NotQuiteApex/JukeBox/README.md

# JukeBox!

An affordable, adorable, powerful hotkey device to run macros, play funny sounds, mute your microphone, change paint brush settings, or manage items in OBS! It can even have RGB or show PC stats!

(TODO: image here)

# Disclaimer
While this project is public, it is not ready for any sort of prime time.

# Docs and Assets
If you are the proud owner of a new JukeBox, or are building your own, take a look at the [getting started doc](docs/getting-started.md).

Sadly, not every program is compatible with these additional function keys, and some do not allow the use of these keys. There is a running list [here](docs/program-compatibility.md) of what programs do and do not work with the keys provided by JukeBox.

# Nightly builds
Each component of the project is built as it is updated. You can grab the latest version of each below. Nightly links provided by [nightly.link](https://nightly.link/).

| [Software, Windows (N/A)](https://nightly.link/FriendTeamInc/JukeBox/workflows/build-software.yaml/main/jb-software-windows.zip) | [Software, Linux](https://nightly.link/FriendTeamInc/JukeBox/workflows/build-software.yaml/main/jb-software-linux.zip) | [Firmware](https://nightly.link/FriendTeamInc/JukeBox/workflows/build-firmware.yaml/main/jb-firmware.zip) | [Hardware, Case](https://nightly.link/FriendTeamInc/JukeBox/workflows/build-hardware-case.yaml/main/jb-hardware-case.zip) | [Hardware, PCB](https://nightly.link/FriendTeamInc/JukeBox/workflows/build-hardware-pcb.yaml/main/jb-hardware-pcb.zip) |
| - | - | - | - | - |

# License
Copyright (c) 2020-2025 Logan "NotQuiteApex" Hickok-Dickson

All programming files, found in [`firmware/`](firmware/), [`software/`](software/), and [`hardware-case/`](hardware-case), are licensed under the [MIT license](https://mit-license.org/). All CAD files, found in [`hardware-pcb/`](hardware-pcb/), unless otherwise provided by an external source such as footprints or 3D models, are licesned under the [CC BY-NC-SA license](https://creativecommons.org/licenses/by-nc-sa/4.0/). Both licenses can be found with the given links or as files in the root of this repostiory.

If you would like to sell a variation of the board designed by you, reach out and an alternative license can be discussed and granted.
