NotQuiteApex/JukeBox/hardware-case/README.md

# JukeBox Case
Made with OpenSCAD 2024 (nightly), protects everything inside the JukeBox.
