NotQuiteApex/JukeBox/hardware-pcb/footprints/WS2812-2020.STEP

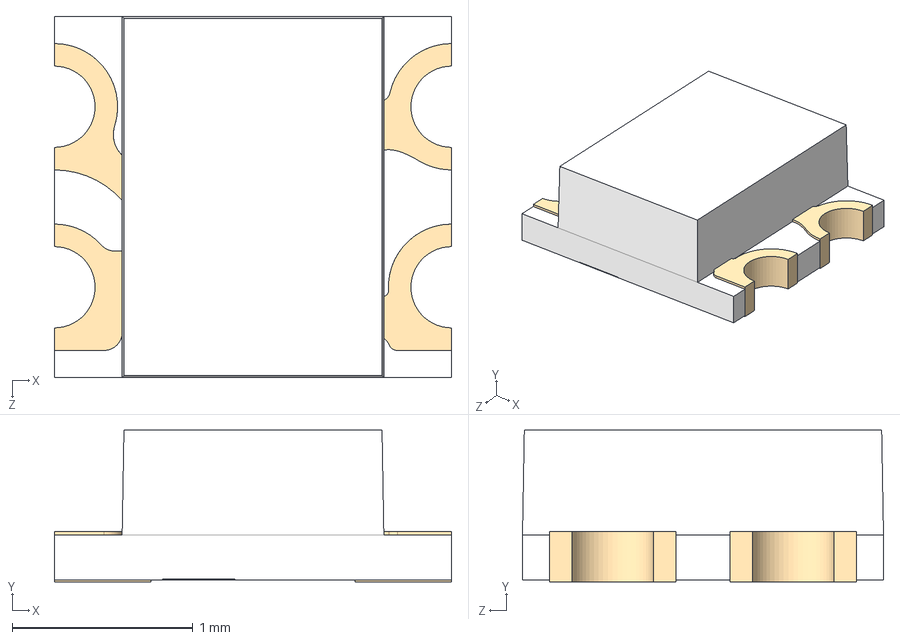
[picture p1: CAD file, 2024-10-28]
hardware-pcb/footprints/WS2812-2020.STEP
2.20 x 0.84 x 2.00 mm
