NotQuiteApex/JukeBox/hardware-pcb/footprints/SM04B-SRSS-TB(LF)(SN).STEP

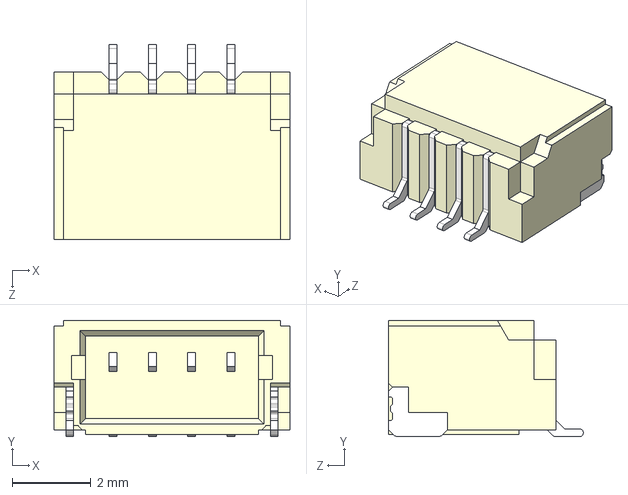
[picture p2: CAD file, 2024-10-28]
hardware-pcb/footprints/SM04B-SRSS-TB(LF)(SN).STEP
6.00 x 2.96 x 4.95 mm
