NotQuiteApex/JukeBox/hardware-pcb/JukeBox.kicad_pcb

## KiCad design hardware-pcb/JukeBox.kicad_pcb (2024-12-14)

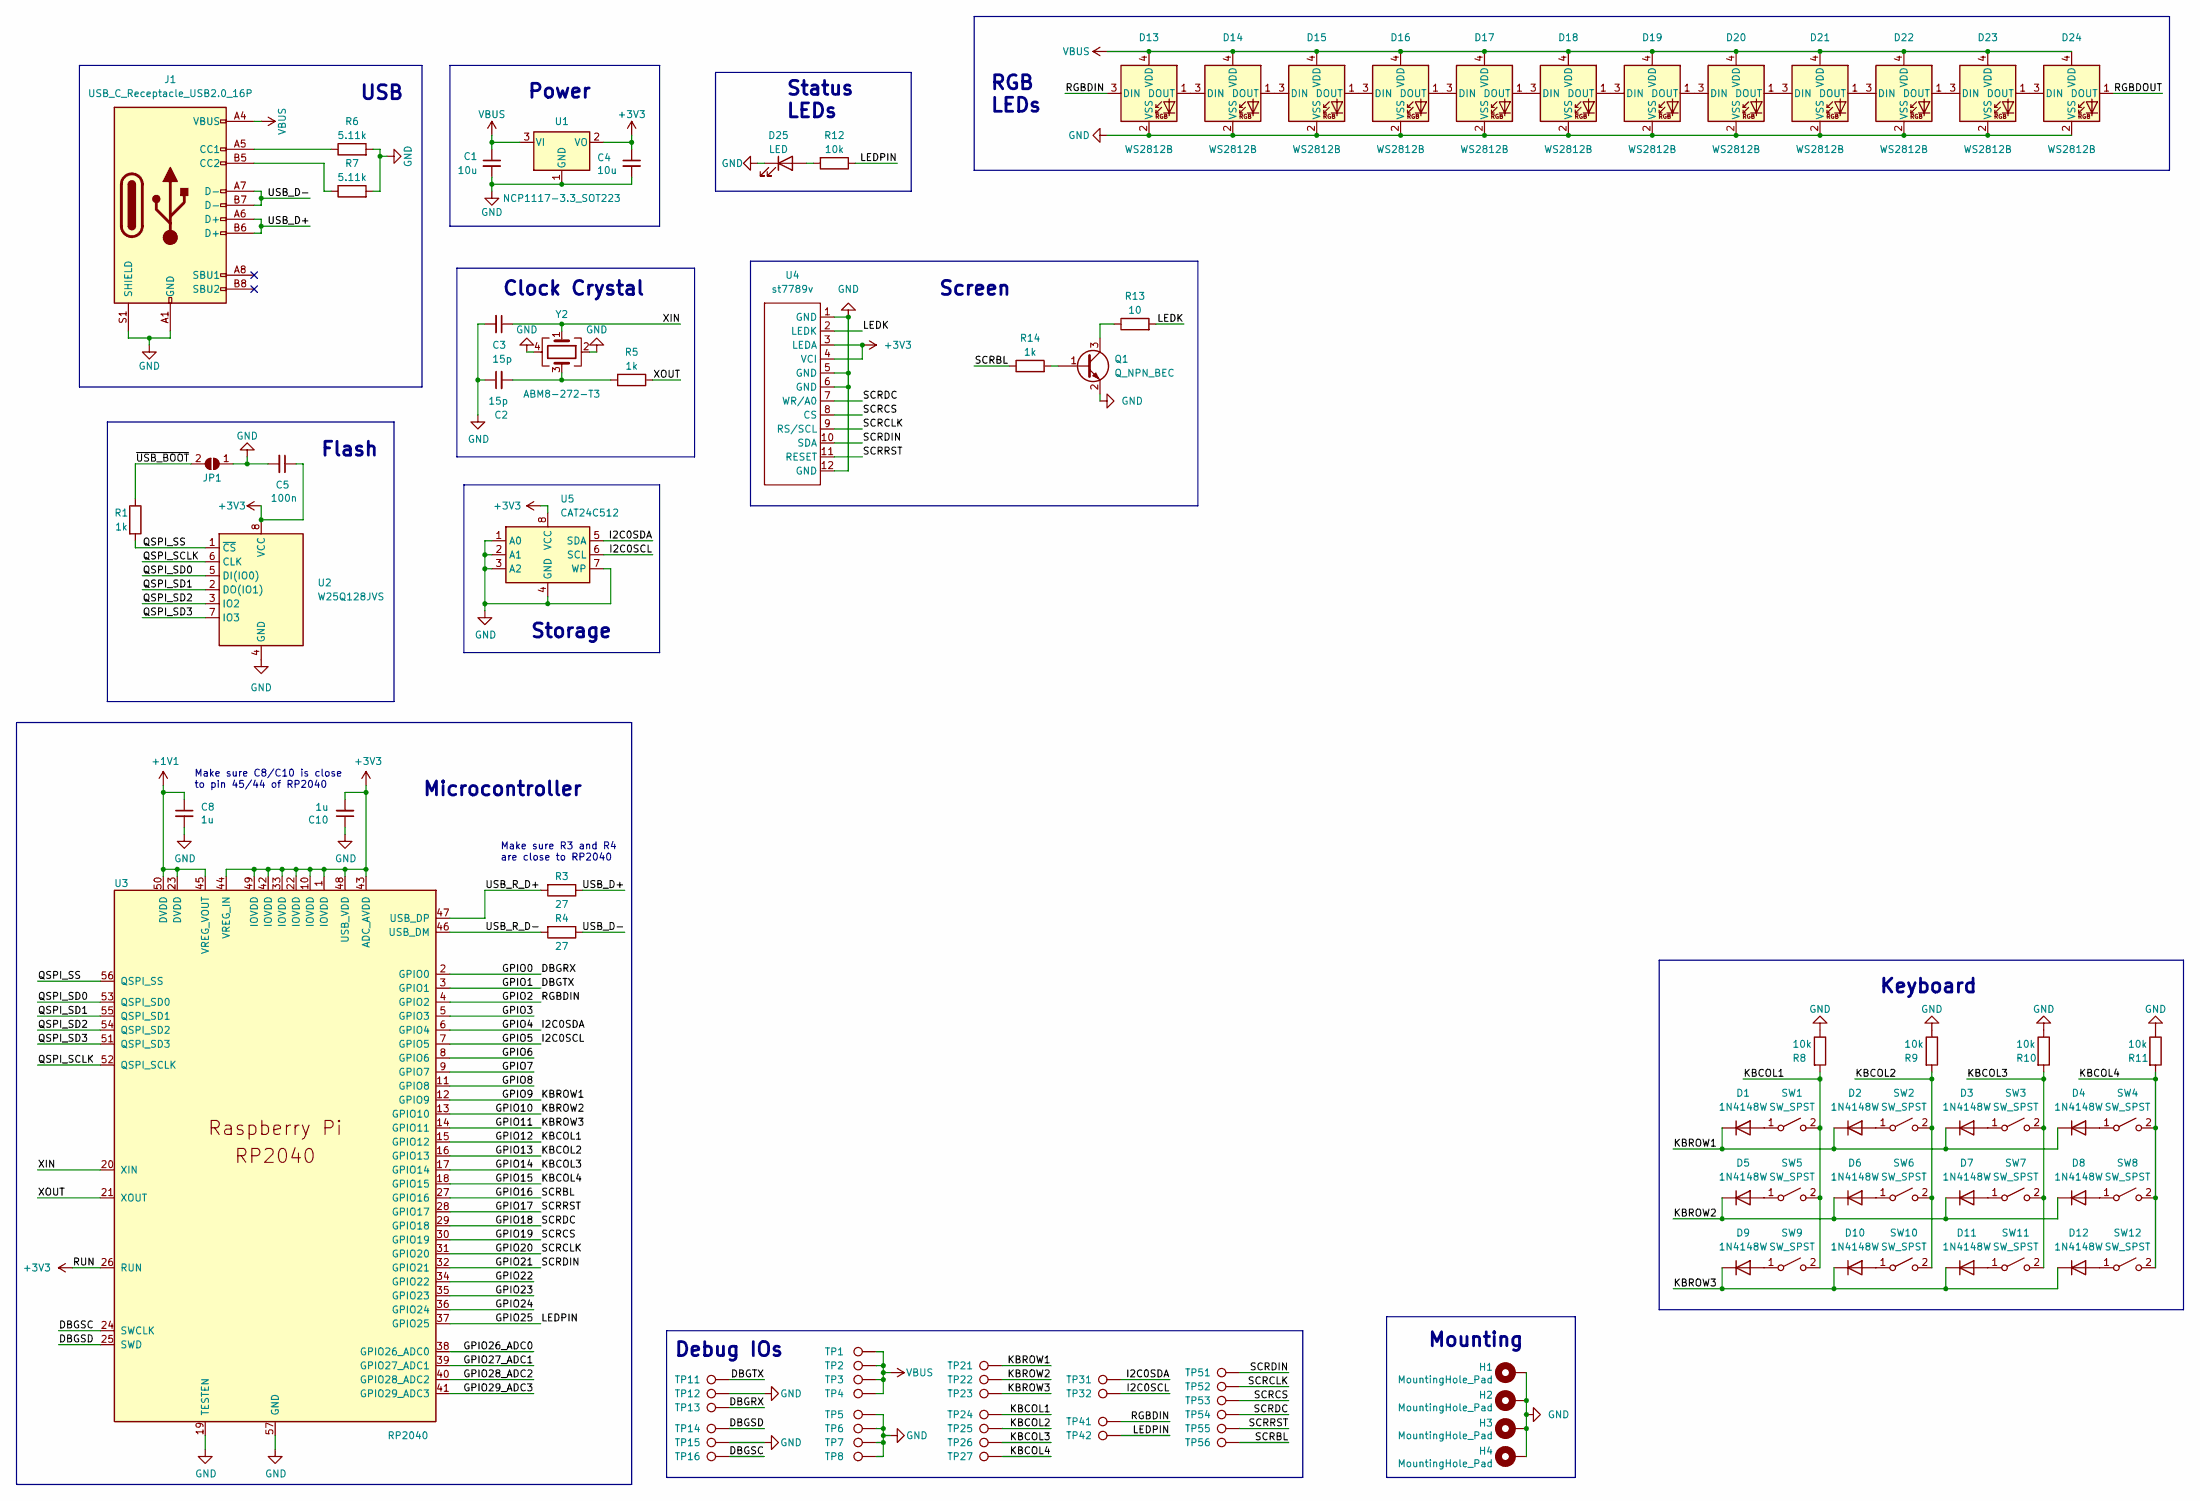
[picture p3: schematic JukeBox.kicad_sch, JukeBoxV5]

Parts:
C1, C4: 10u; C_0805_2012Metric
C2, C3: 15p; C_0402_1005Metric
C5: 100n; C_0402_1005Metric
C8, C10: 1u; C_0402_1005Metric
D1, D2, D3, D4, D5, D6, D7, D8, D9, D10, D11, D12: 1N4148W; D_SOD-123
D13, D14, D15, D16, D17, D18, D19, D20, D21, D22, D23, D24: WS2812B; LED_WS2812B-2020_PLCC4_2.0x2.0mm
D25: LED; D_0805_2012Metric_Pad1.15x1.40mm_HandSolder
H1, H2, H3, H4: MountingHole_Pad; MountingHole_3.2mm_M3_Pad_Via
J1: USB_C_Receptacle_USB2.0_16P; USB_C_Receptacle_GCT_USB4105-xx-A_16P_TopMnt_Horizontal
JP1: SolderJumper_2_Open; SolderJumper-2_P1.3mm_Open_RoundedPad1.0x1.5mm
Q1: Q_NPN_BEC; SOT-23
R1, R5, R14: 1k; R_0402_1005Metric
R3, R4: 27; R_0402_1005Metric
R6, R7: 5.11k; R_0402_1005Metric
R8, R9, R10, R11, R12: 10k; R_0402_1005Metric
R13: 10; R_0402_1005Metric
SW1, SW2, SW3, SW4, SW5, SW6, SW7, SW8, SW9, SW10, SW11, SW12: SW_SPST; ALLKEY
TP1, TP2, TP3, TP4, TP5, TP6, TP7, TP8, TP11, TP12, TP13, TP14, TP15, TP16, TP21, TP22, TP23, TP24, TP25, TP26, TP27, TP31, TP32, TP41, TP42, TP51, TP52, TP53, TP54, TP55, TP56: TestPoint; TestPoint_Pad_D1.5mm
U1: NCP1117-3.3_SOT223; SOT-223-3_TabPin2
U2: W25Q128JVS; SOIC-8_5.23x5.23mm_P1.27mm
U3: RP2040; RP2040-QFN-56
U4: st7789v
U5: CAT24C512; SOIC-8_3.9x4.9mm_P1.27mm
Y2: ABM8-272-T3; Crystal_SMD_Abracon_ABM8G-4Pin_3.2x2.5mm

Connections:
+1V1: C8.1, U3.23 (DVDD), U3.45 (VREG_VOUT), U3.50 (DVDD)
+3V3: C4.1, C5.1, C10.2, U1.2 (VO), U2.8 (VCC), U3.1 (IOVDD), U3.10 (IOVDD), U3.22 (IOVDD), U3.26 (RUN), U3.33 (IOVDD), U3.42 (IOVDD), U3.43 (ADC_AVDD), U3.44 (VREG_IN), U3.48 (USB_VDD), U3.49 (IOVDD), U4.3 (LEDA), U4.4 (VCI), U5.8 (VCC); also elsewhere on the board
/DBGRX: TP13.1, U3.2 (GPIO0)
/DBGSC: TP16.1, U3.24 (SWCLK)
/DBGSD: TP14.1, U3.25 (SWD)
/DBGTX: TP11.1, U3.3 (GPIO1)
/GPIO2: D13.3 (DIN), TP41.1, U3.4 (GPIO2)
/GPIO3: U3.5 (GPIO3)
/GPIO4: TP31.1, U3.6 (GPIO4), U5.5 (SDA)
/GPIO5: TP32.1, U3.7 (GPIO5), U5.6 (SCL)
/GPIO6: U3.8 (GPIO6)
/GPIO7: U3.9 (GPIO7)
/GPIO8: U3.11 (GPIO8)
/GPIO9: D1.2 (K), D2.2 (K), D3.2 (K), D4.2 (K), TP21.1, U3.12 (GPIO9)
/GPIO10: D5.2 (K), D6.2 (K), D7.2 (K), D8.2 (K), TP22.1, U3.13 (GPIO10)
/GPIO11: D9.2 (K), D10.2 (K), D11.2 (K), D12.2 (K), TP23.1, U3.14 (GPIO11)
/GPIO12: R8.2, SW1.2 (B), SW5.2 (B), SW9.2 (B), TP24.1, U3.15 (GPIO12)
/GPIO13: R9.2, SW2.2 (B), SW6.2 (B), SW10.2 (B), TP25.1, U3.16 (GPIO13)
/GPIO14: R10.2, SW3.2 (B), SW7.2 (B), SW11.2 (B), TP26.1, U3.17 (GPIO14)
/GPIO15: R11.2, SW4.2 (B), SW8.2 (B), SW12.2 (B), TP27.1, U3.18 (GPIO15)
/GPIO16: R14.1, TP56.1, U3.27 (GPIO16)
/GPIO17: TP55.1, U3.28 (GPIO17), U4.11 (RESET)
/GPIO18: TP54.1, U3.29 (GPIO18), U4.7 (WR/A0)
/GPIO19: TP53.1, U3.30 (GPIO19), U4.8 (CS)
/GPIO20: TP52.1, U3.31 (GPIO20), U4.9 (RS/SCL)
/GPIO21: TP51.1, U3.32 (GPIO21), U4.10 (SDA)
/GPIO22: U3.34 (GPIO22)
/GPIO23: U3.35 (GPIO23)
/GPIO24: U3.36 (GPIO24)
/GPIO25: R12.1, TP42.1, U3.37 (GPIO25)
/GPIO26_ADC0: U3.38 (GPIO26_ADC0)
/GPIO27_ADC1: U3.39 (GPIO27_ADC1)
/GPIO28_ADC2: U3.40 (GPIO28_ADC2)
/GPIO29_ADC3: U3.41 (GPIO29_ADC3)
/LEDK: R13.2, U4.2 (LEDK)
/QSPI_SCLK: U2.6 (CLK), U3.52 (QSPI_SCLK)
/QSPI_SD0: U2.5 (DI(IO0)), U3.53 (QSPI_SD0)
/QSPI_SD1: U2.2 (DO(IO1)), U3.55 (QSPI_SD1)
/QSPI_SD2: U2.3 (IO2), U3.54 (QSPI_SD2)
/QSPI_SD3: U2.7 (IO3), U3.51 (QSPI_SD3)
/QSPI_SS: R1.2, U2.1 (~CS), U3.56 (QSPI_SS)
/RGBDOUT: D24.1 (DOUT)
/USB_D+: J1.A6 (D+), J1.B6 (D+), R3.1
/USB_D-: J1.A7 (D-), J1.B7 (D-), R4.1
/USB_R_D+: R3.2, U3.47 (USB_DP)
/USB_R_D-: R4.2, U3.46 (USB_DM)
/XIN: C3.1, U3.20 (XIN), Y2.1
/XOUT: R5.1, U3.21 (XOUT)
/~USB_BOOT: JP1.2 (B), R1.1
GND: C1.2, C2.1, C3.2, C4.2, C5.2, C8.2, C10.1, D13.2 (VSS), D14.2 (VSS), D15.2 (VSS), D16.2 (VSS), D17.2 (VSS), D18.2 (VSS), D19.2 (VSS), D20.2 (VSS), D21.2 (VSS), D22.2 (VSS), D23.2 (VSS), D24.2 (VSS), D25.1 (K), H1.1, H2.1, H3.1, H4.1, J1.A1 (GND), J1.A12 (GND), J1.B1 (GND), J1.B12 (GND), J1.S1 (SHIELD), JP1.1 (A), Q1.2 (E), R6.2, R7.2, R8.1, R9.1, R10.1, R11.1, TP5.1, TP6.1, TP7.1, TP8.1, TP12.1, TP15.1, U1.1 (GND), U2.4 (GND), U3.19 (TESTEN), U3.57 (GND), U4.1 (GND), U4.5 (GND), U4.6 (GND), U4.12 (GND), U5.1 (A0), U5.2 (A1), U5.3 (A2), U5.4 (GND), U5.7 (WP), Y2.2, Y2.4
unnamed: C2.2, R5.2, Y2.3
unnamed: D1.1 (A), SW1.1 (A)
unnamed: D2.1 (A), SW2.1 (A)
unnamed: D3.1 (A), SW3.1 (A)
unnamed: D4.1 (A), SW4.1 (A)
unnamed: D5.1 (A), SW5.1 (A)
unnamed: D6.1 (A), SW6.1 (A)
unnamed: D7.1 (A), SW7.1 (A)
unnamed: D8.1 (A), SW8.1 (A)
unnamed: D9.1 (A), SW9.1 (A)
unnamed: D10.1 (A), SW10.1 (A)
unnamed: D11.1 (A), SW11.1 (A)
unnamed: D12.1 (A), SW12.1 (A)
unnamed: D13.1 (DOUT), D14.3 (DIN)
unnamed: D14.1 (DOUT), D15.3 (DIN)
unnamed: D15.1 (DOUT), D16.3 (DIN)
unnamed: D16.1 (DOUT), D17.3 (DIN)
unnamed: D17.1 (DOUT), D18.3 (DIN)
unnamed: D18.1 (DOUT), D19.3 (DIN)
unnamed: D19.1 (DOUT), D20.3 (DIN)
unnamed: D20.1 (DOUT), D21.3 (DIN)
unnamed: D21.1 (DOUT), D22.3 (DIN)
unnamed: D22.1 (DOUT), D23.3 (DIN)
unnamed: D23.1 (DOUT), D24.3 (DIN)
unnamed: D25.2 (A), R12.2
unnamed: J1.A5 (CC1), R6.1
unnamed: J1.B5 (CC2), R7.1
unnamed 77: Q1.1 (B), R14.2; also elsewhere on the board
unnamed: Q1.3 (C), R13.1
VBUS: C1.1, D13.4 (VDD), D14.4 (VDD), D15.4 (VDD), D16.4 (VDD), D17.4 (VDD), D18.4 (VDD), D19.4 (VDD), D20.4 (VDD), D21.4 (VDD), D22.4 (VDD), D23.4 (VDD), D24.4 (VDD), J1.A4 (VBUS), J1.A9 (VBUS), J1.B4 (VBUS), J1.B9 (VBUS), TP1.1, TP2.1, TP3.1, TP4.1, U1.3 (VI)

Notes on the sheet:
Flash
Make sure C8/C10 is close to pin 45/44 of RP2040
Mounting
Debug IOs
Storage
Keyboard
USB
Make sure R3 and R4 are close to RP2040
RGB LEDs
Screen
Power
Clock Crystal
Microcontroller
Status LEDs

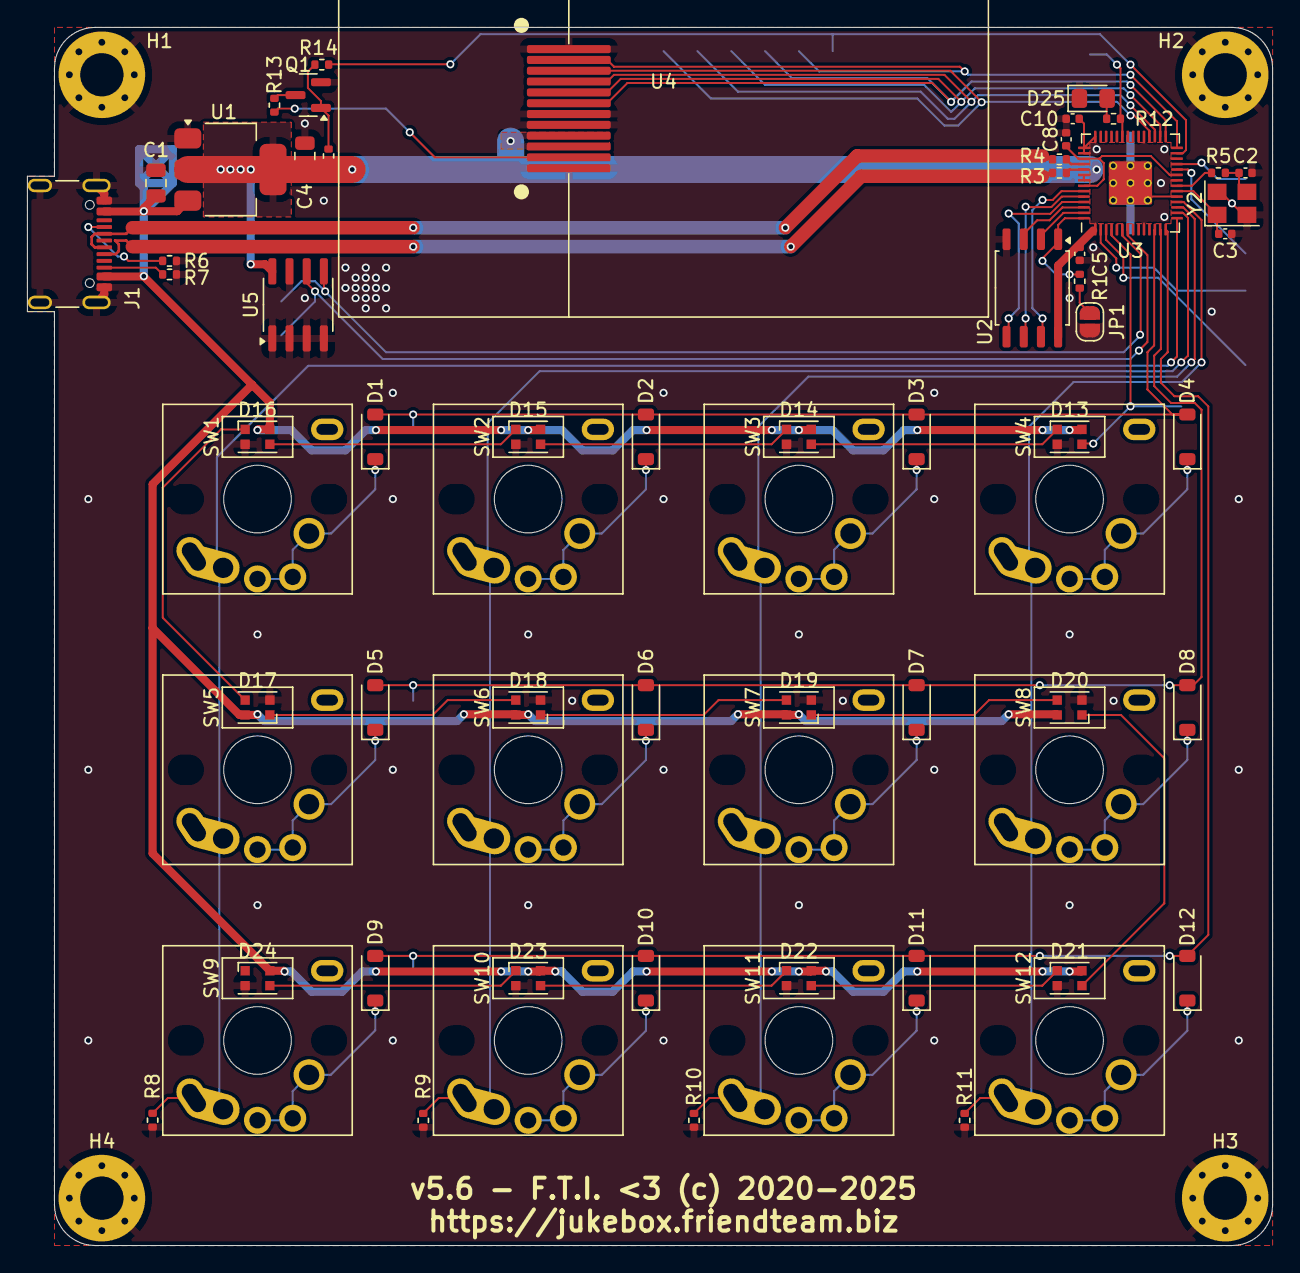
[picture p4: board JukeBox.kicad_pcb from above]

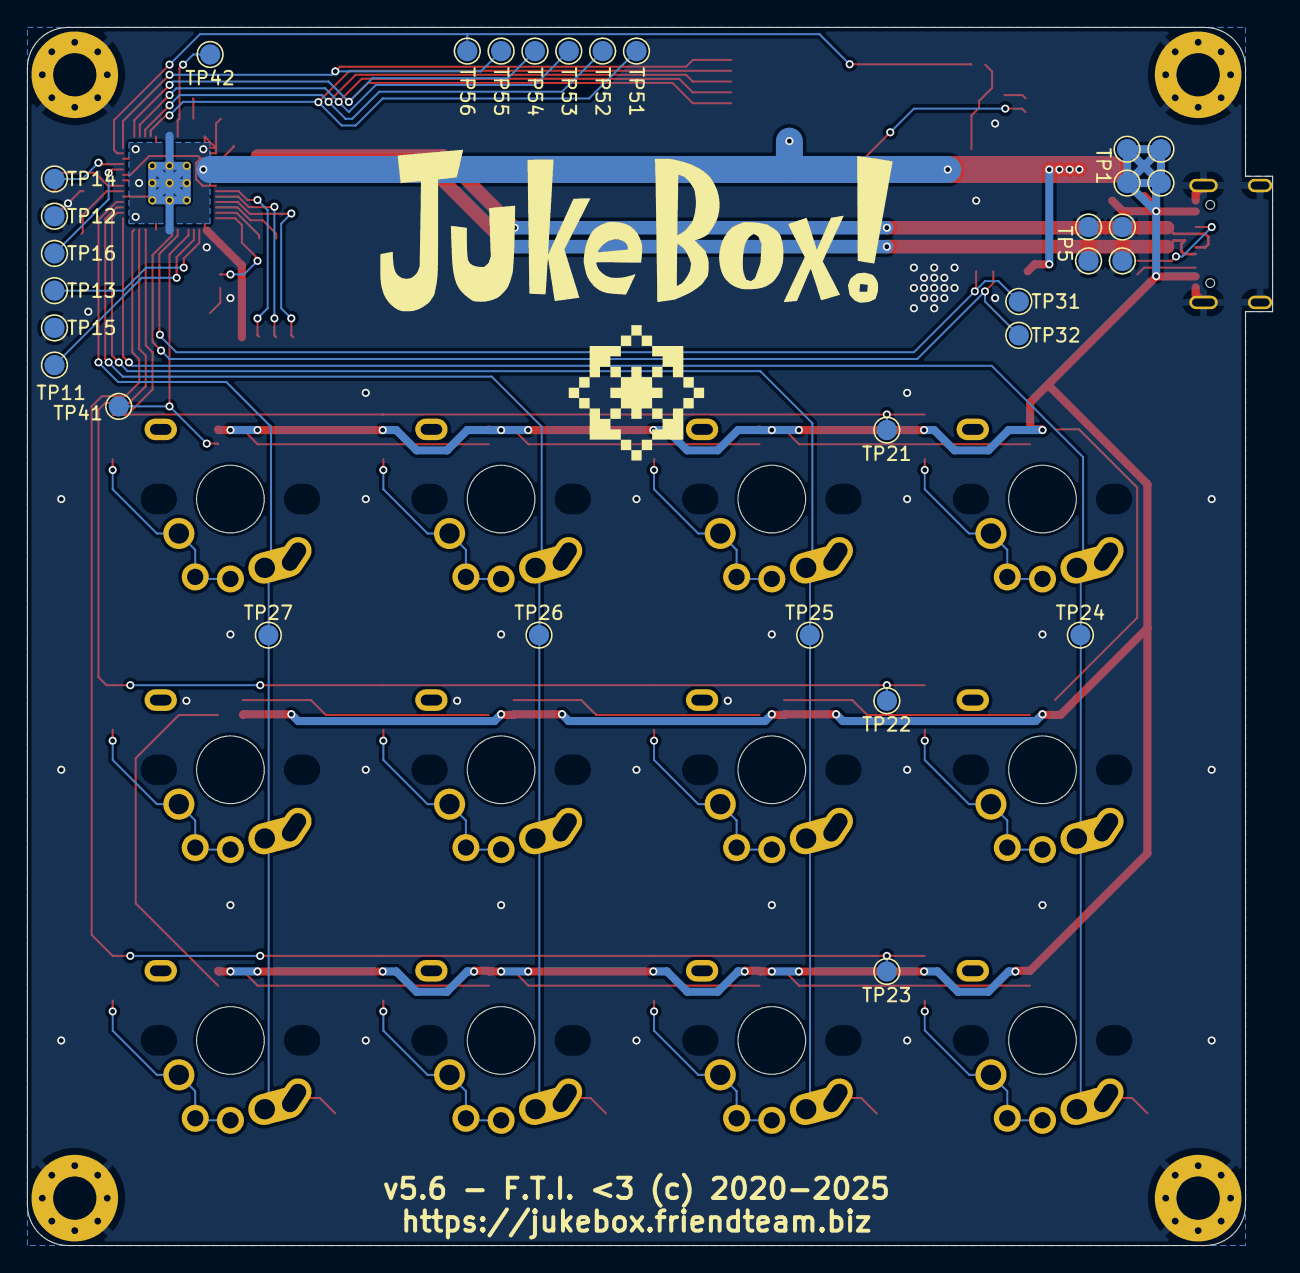
[picture p5: board JukeBox.kicad_pcb from below]

Board: 2 copper layers, 92.0 x 90.0 mm, 103 parts (32 on the bottom side), 68 nets.

Other parts of the board:
G1: LOGO; JukeBox
R15: 10k; R_0402_1005Metric

Their connections:
+3V3: R15.1; also elsewhere on the board
unnamed 77: R15.2; also elsewhere on the board
