NotQuiteApex/JukeBox/board/JuiceBox.kicad_pcb

## KiCad design board/JuiceBox.kicad_pcb (2022-09-27)

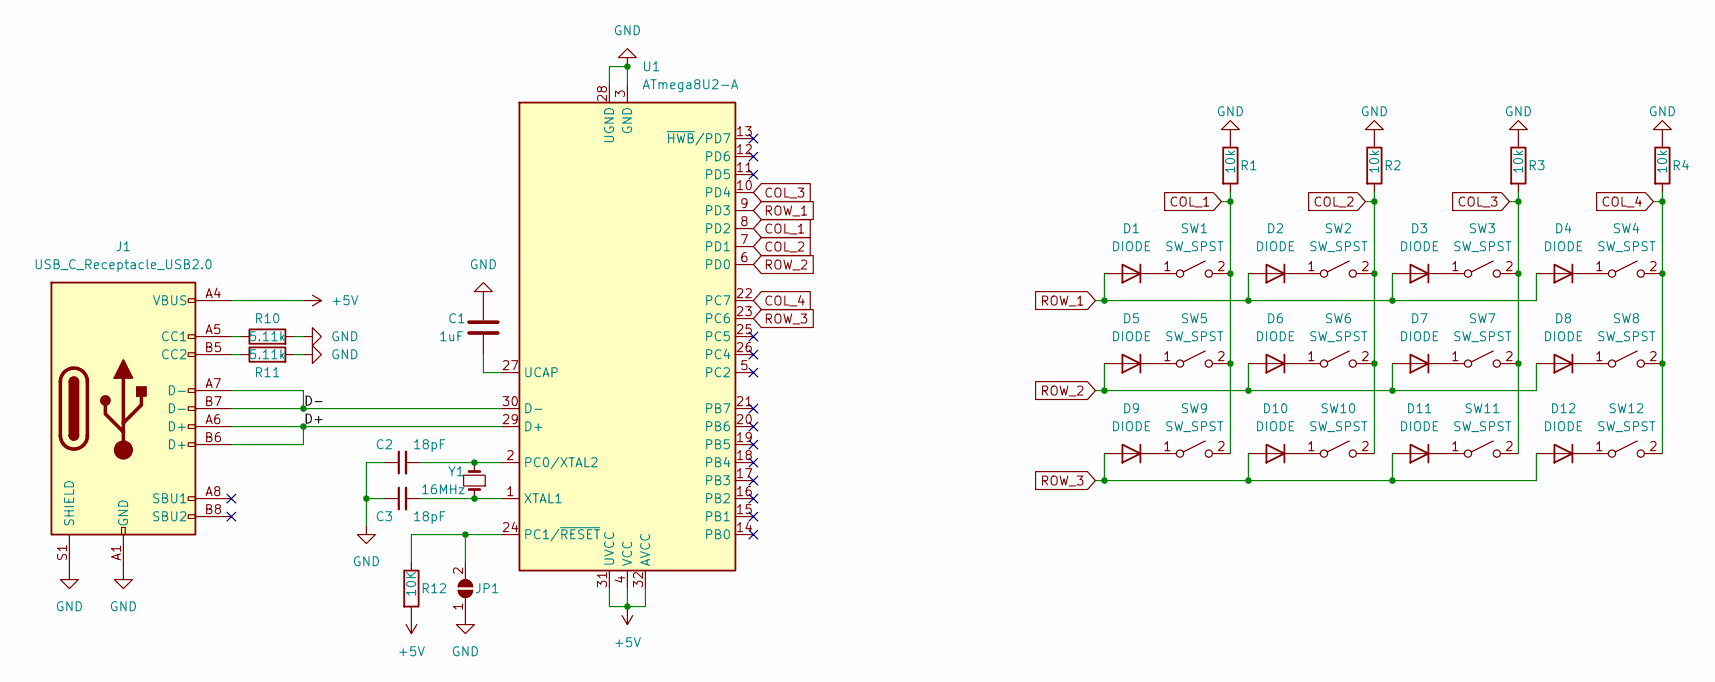
[picture p6: schematic JuiceBox.kicad_sch]

Parts:
C1: 1uF; C_Disc_D5.0mm_W2.5mm_P5.00mm
C2, C3: 18pF; C_Disc_D5.0mm_W2.5mm_P5.00mm
D1, D2, D3, D4, D5, D6, D7, D8, D9, D10, D11, D12: DIODE; D_DO-15_P10.16mm_Horizontal
J1: USB_C_Receptacle_USB2.0; GCT_USB4085-GF-A_REVA4
JP1: SolderJumper-2_P1.3mm_Open_Pad1.0x1.5mm
R1, R2, R3, R4: 10k; R_Axial_DIN0207_L6.3mm_D2.5mm_P10.16mm_Horizontal
R10, R11: 5.11k; R_Axial_DIN0207_L6.3mm_D2.5mm_P10.16mm_Horizontal
R12: 10K; R_Axial_DIN0207_L6.3mm_D2.5mm_P10.16mm_Horizontal
SW1, SW2, SW3, SW4, SW5, SW6, SW7, SW8, SW9, SW10, SW11, SW12: SW_SPST; SW_Cherry_MX_1.00u_PCB
U1: ATmega8U2-A; TQFP-32_7x7mm_P0.8mm
Y1: 16MHz; Crystal_HC18-U_Vertical

Connections:
+5V: J1.A4 (VBUS), J1.A9 (VBUS), J1.B4 (VBUS), J1.B9 (VBUS), R12.2, U1.4 (VCC), U1.31 (UVCC), U1.32 (AVCC)
/D+: J1.A6 (D+), J1.B6 (D+), U1.29 (D+)
/D-: J1.A7 (D-), J1.B7 (D-), U1.30 (D-)
COL_1: R1.2, SW1.2 (B), SW5.2 (B), SW9.2 (B), U1.8 (PD2)
COL_2: R2.2, SW2.2 (B), SW6.2 (B), SW10.2 (B), U1.7 (PD1)
COL_3: R3.2, SW3.2 (B), SW7.2 (B), SW11.2 (B), U1.10 (PD4)
COL_4: R4.2, SW4.2 (B), SW8.2 (B), SW12.2 (B), U1.22 (PC7)
GND: C1.1, C2.1, C3.1, J1.A1 (GND), J1.A12 (GND), J1.B1 (GND), J1.B12 (GND), J1.S1 (SHIELD), JP1.1 (A), R1.1, R2.1, R3.1, R4.1, R10.2, R11.2, U1.3 (GND), U1.28 (UGND)
unnamed: C1.2, U1.27 (UCAP)
unnamed: C2.2, U1.2 (PC0/XTAL2), Y1.2
unnamed: C3.2, U1.1 (XTAL1), Y1.1
unnamed: D1.2 (K), SW1.1 (A)
unnamed: D2.2 (K), SW2.1 (A)
unnamed: D3.2 (K), SW3.1 (A)
unnamed: D4.2 (K), SW4.1 (A)
unnamed: D5.2 (K), SW5.1 (A)
unnamed: D6.2 (K), SW6.1 (A)
unnamed: D7.2 (K), SW7.1 (A)
unnamed: D8.2 (K), SW8.1 (A)
unnamed: D9.2 (K), SW9.1 (A)
unnamed: D10.2 (K), SW10.1 (A)
unnamed: D11.2 (K), SW11.1 (A)
unnamed: D12.2 (K), SW12.1 (A)
unnamed: J1.A5 (CC1), R10.1
unnamed: J1.B5 (CC2), R11.1
unnamed: JP1.2 (B), R12.1, U1.24 (PC1/~RESET)
ROW_1: D1.1 (A), D2.1 (A), D3.1 (A), D4.1 (A), U1.9 (PD3)
ROW_2: D5.1 (A), D6.1 (A), D7.1 (A), D8.1 (A), U1.6 (PD0)
ROW_3: D9.1 (A), D10.1 (A), D11.1 (A), D12.1 (A), U1.23 (PC6)

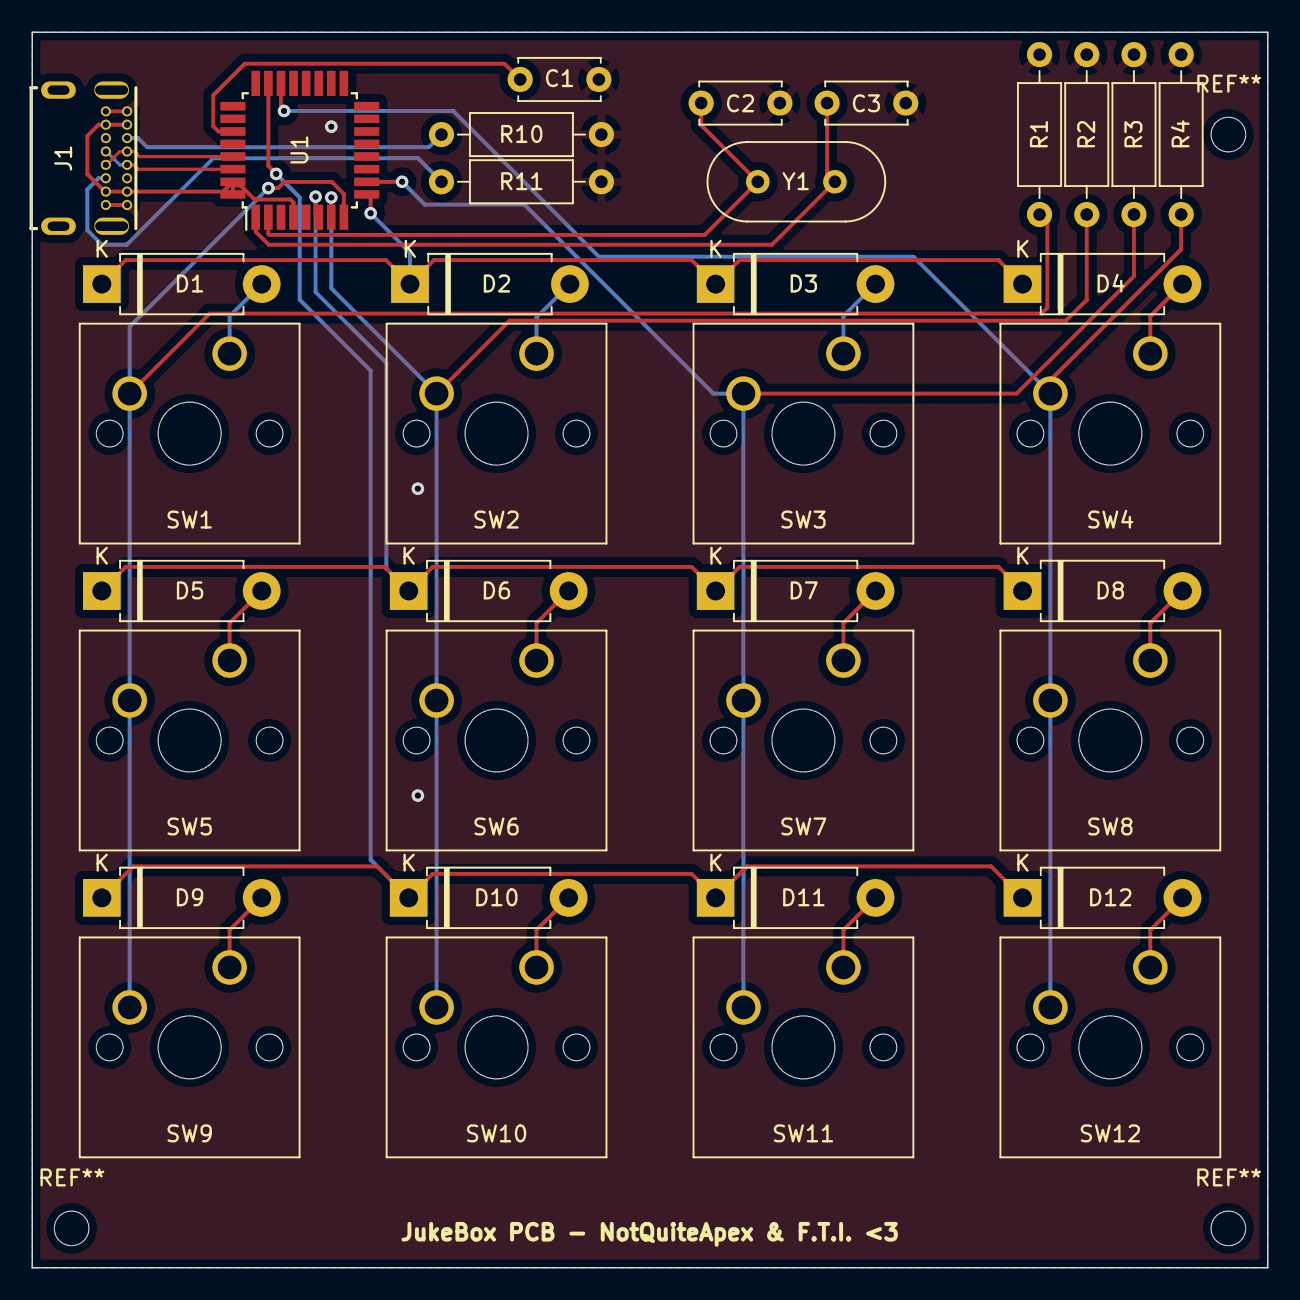
[picture p7: board JuiceBox.kicad_pcb from above]

Board: 2 copper layers, 78.5 x 78.5 mm, 36 parts (0 on the bottom side), 28 nets.
