NotQuiteApex/JukeBox/(commit log)

2021-12-21 add usb, atmega8u2, and key matrix
    [JuiceBox.kicad_sch]
2021-12-21 add crystal for usb operation
    [JuiceBox.kicad_sch]
2021-12-21 add usb c connector, connect everything together
    [JuiceBox.kicad_pcb, JuiceBox.kicad_sch]
2022-09-23 move all components to top, all throughhole
    [JuiceBox.kicad_pcb, JuiceBox.kicad_sch]
2022-09-27 route pads and throughholes
    [JuiceBox.kicad_pcb]
2022-09-27 update naming, add headers for direct connection
    [JukeBox.kicad_pcb, JukeBox.kicad_sch]
2022-09-27 route headers for direct access to keys
    [JukeBox.kicad_pcb]
2022-09-28 update footprints
    [JukeBox.kicad_sch]
2022-09-28 update readme with link to footprints
2022-09-28 add kailh choc switches in place of cherry mx's
    [JukeBox.kicad_pcb, JukeBox.kicad_sch]
2022-09-28 update traces and usb c pads
    [JukeBox.kicad_pcb]
2022-09-29 fix some traces that werent connected properly
    [JukeBox.kicad_pcb]
2022-09-29 fast forward
    [JukeBox.kicad_pcb]
2022-10-08 mix cherry mx and kailh footprints1
    [JukeBox.kicad_pcb]
2022-10-09 fix all traces for dual sockets
    [JukeBox.kicad_pcb]
2022-10-09 reroute everything again to move the mcu over
    [JukeBox.kicad_pcb]
2022-10-09 update models
    [JukeBox.kicad_pcb, JukeBox.kicad_sch, cherry-mx-switch.step, kailh-choc-switch.step]
2022-10-10 add footprint for screen addon, change all tht components to smt
    [JukeBox.kicad_pcb, JukeBox.kicad_sch]
2022-10-10 ran a drc, fix some errors
    [JukeBox.kicad_pcb]
2022-10-15 add resistors to schematic, add mcu programming docs, add star to platformio stuff for atmega8u2
    [JukeBox.kicad_sch]
2022-10-15 fix resistors for usb in pcb
    [JukeBox.kicad_pcb]
2022-10-15 add atmega8u2 "board", add lufa, get a proper build
2022-10-16 start work on adding usb descriptors and device details
2022-10-17 add macros for vid, pid, product string and manufacturer string
2022-10-20 fix some pinouts, try testing pin reading (its not working)
2022-10-21 adjust directions for power
2022-10-22 fix descriptors, fix global interrupts being disabled
2022-11-14 add document for device compatibility, fix notes in programming mcu doc, and add board json for atmega16u2
2022-11-14 move license, update mcu readme, add print stl's (no openscad yet)
    [case-bottom.stl, case-leg.stl, case-top-cherry-mx.stl, case-top-kailh-choc.stl, cherry-mx-keycap.stl]
2022-11-14 update readme, fix keycap filename
    [keycap-cherry-mx.stl]
2023-09-02 start on adding pico board work
2023-09-14 add driver for st7789, do some basic example work
2023-09-19 update format of the font, move many things into the lcd module, add coloring and text printing proper
2023-10-16 fix some minor bugs relating to tray icon and tray menu, limit devices that show up to specific vid/pid's, and fix some styling
2023-11-27 update functions for printing
2023-12-02 fix usb mount speed, experiment with screen orientation
2023-12-02 import rp2040 minimal kicad project
    [JukeBox.kicad_pcb, JukeBox.kicad_sch, cherry-mx-switch.step, kailh-choc-switch.step]
2023-12-03 fix pinout, update schematic
    [JukeBox.kicad_sch]
2023-12-03 add some new footprints and 3d models
    [JukeBox.kicad_sch, cherry-mx-switch.step, kailh-choc-switch.step]
2023-12-03 first pass over pcb
    [JukeBox.kicad_pcb, JukeBox.kicad_sch]
2023-12-03 second pass pcb
    [JukeBox.kicad_pcb, JukeBox.kicad_sch]
2023-12-06 minor board adjustments
    [JukeBox.kicad_pcb]
2023-12-07 remove stat string padding, add scaling for printing, update timeout time
2023-12-07 move tasks to second core for performance
    thank god tinyusb is threadsafe
2023-12-08 fix rust desktop issues
    [main.rs]
2023-12-10 remove unnecessary functions, add more proper error handling
    [main.rs, serial.rs]
2023-12-10 move all pcb components to top layer
    [JukeBox.kicad_pcb, JukeBox.kicad_sch, USB4105-GF-A.step]
2023-12-10 add models to pcb, adjust some resistor placement
    [JukeBox.kicad_pcb]
2023-12-11 minor adjustments
    [JukeBox.kicad_pcb, JukeBox.kicad_sch]
2023-12-11 change sizes of all the smd's to match parts, remove unnecessary pullup
    [JukeBox.kicad_sch]
2023-12-11 fix pcb for new footprints, remove old files, update readme
    [JukeBox.kicad_pcb, JukeBox.kicad_sch]
2023-12-11 remove old prints
    [case-bottom.stl, case-leg.stl, case-top-cherry-mx.stl, case-top-kailh-choc.stl, keycap-cherry-mx.stl]
2023-12-11 update project structure, update readme
    [JukeBox.kicad_pcb, JukeBox.kicad_sch, USB4105-GF-A.step, cherry-mx-switch.step, kailh-choc-switch.step]
2023-12-12 experiment with components on windows (failing miserably)
    [build.rs, main.rs, serial.rs]
2023-12-13 fix bad dependency usage, update fmt
    [main.rs, serial.rs]
2023-12-14 update heartbeat timeout, update probe, update cpu updates from sysinfo
2023-12-16 fix unnecessary slowdown of nvml constantly reinitializing the device
2023-12-17 update fill zones, use instants instead of systime, add notes
    [JukeBox.kicad_pcb]
2023-12-19 move usb on board downward for leg spacing
    [JukeBox.kicad_pcb]
2023-12-21 update routing for usb, add logos
    [JukeBox.kicad_pcb]
2023-12-22 start on cad files (with openscad)
    [case.scad]
2023-12-22 add text logo, update case top
    [case.scad]
2023-12-23 IMPORTANT: branches have been swapped
    main -> old-atmega
    v5-board -> main
    the old branch is now so different from the recent work that merging makes no sense, so the old branch has been "archived" and the new branch is now the main branch
2023-12-23 change directory layout for hardware.
    [JukeBox.kicad_pcb, JukeBox.kicad_sch, USB4105-GF-A.step, case.scad, cherry-mx-switch.step, kailh-choc-switch.step]
2023-12-23 switch to apt-get, upload artifact for firmware
2023-12-24 fix exe upload, fix missing checkout for case (and pcb)
2023-12-24 fix path for svg in case file, fix missing artifact upload for build
    [case.scad]
2023-12-24 change all variables to parameters, add conditional generation
    [case.scad]
2023-12-24 add build script for case files
2023-12-24 remove options for case build script
2023-12-24 change case resolution, start on merging artifacts
    [case.scad]
2023-12-25 add case legs
    [case.scad]
2023-12-25 add gerber plotting for pcb
2023-12-25 update readme to reflect supported pcb artifacts
2023-12-26 fix some unnecessary "center=true"s, update hole sizes for M3 instead of M2.5 (as M3 is more widely available)
    [case.scad]
2023-12-26 change mounting holes to M3 from M2.5
    [JukeBox.kicad_pcb, JukeBox.kicad_sch]
2023-12-27 add more variables for the case, lots of adjustments
    [case.scad]
2023-12-27 add support poles under keyboard center
    [case.scad]
2023-12-27 change bolt and nut size
    [case.scad]
2023-12-27 update spacing for mounting, keyboard
    [case.scad]
2023-12-27 add screen casing generation
    [case.scad]
2023-12-27 adjust nut depth
    commit messages made unironically by the utterly deranged
    [case.scad]
2023-12-27 update leg spacing
    [case.scad]
2023-12-27 leg adjustments, screen adjustments
    [case.scad]
2023-12-27 more screen adjustments
    [case.scad]
2023-12-27 minor screen adjustments, update pinout in firmware
    [case.scad]
2023-12-28 add rubber feet spots to case legs, single core compile for firmware
    [case.scad]
2023-12-28 notes in firmware build, case leg adjustments
    [case.scad]
2023-12-28 update models and remove old footprints
    [JukeBox.kicad_pcb, cherry-mx-switch.step, kailh-choc-switch.step]
2023-12-28 case leg adjustment
    [case.scad]
2023-12-28 update text logo, footprint of text logo, case, and readme
    [JukeBox.kicad_pcb]
2024-01-24 add more pillars for keyboard frame support, fix footprint for firmware chip
    [JukeBox.kicad_pcb, JukeBox.kicad_sch, case.scad]
2024-01-25 add some LCD resetting for when the update command is sent
    [serial.rs]
2024-01-26 add version to gui, update buttons
2024-01-28 fix missing heartbeat, add connected event
    [gui.rs, main.rs, serial.rs]
2024-01-29 fix disconnect on gui close, add proper disconnect message for firmware and software
    [gui.rs, main.rs, serial.rs]
2024-01-29 fix serial not recieving disconnect commands correctly, add more explicit connection status messages
    [gui.rs]
2024-02-01 (temporarily) swap row and col on keyboard, add notes for v5.1
    [JukeBox.kicad_pcb]
2024-02-02 fix keyboard diode direction
    [JukeBox.kicad_pcb, JukeBox.kicad_sch]
2024-02-02 add smaller clock crystal, with adjusted capacitor values
    [ECS-120-20-33-AEL-TR.step, JukeBox.kicad_pcb, JukeBox.kicad_sch]
2024-02-06 disable buttons when disconnected, test version checking, test keyboard input
2024-02-26 add checks for suspended usb thus disable light based components
    [JukeBox.kicad_pcb]
2024-03-22 fix key pins for corrected diodes, add dedicated debug function command, fix LCD not turning off when sleeping, attempt to fix LCD not turning off when updating (doesn't work for some reason)
    [gui.rs, serial.rs]
2024-03-24 fix console window spawning, refmt
    [build.rs, main.rs]
2024-03-24 add some webpage buttons, add splash text
2024-04-07 fix buttons for keyboard panel, remove open crate, adjust some versions
    [gui.rs]
2024-08-18 start on led module
2024-08-18 fix descriptors, add serial test
    [main.rs]
2024-08-20 add case detail component (for multicolor printing)
    [case.scad]
2024-08-21 fix mounting holes for nuts and bolts
    [case.scad]
2024-08-22 fix nut size properly
    [case.scad]
2024-08-22 start on st7789 footprint
2024-08-23 change throughhole pins to test pads, start reassembling pcb
    [JukeBox.kicad_pcb, JukeBox.kicad_sch]
2024-08-23 update to kicad 8
    [JukeBox.kicad_pcb, JukeBox.kicad_sch]
2024-08-24 rearrange board, new 100x100mm design
    [JukeBox.kicad_pcb, JukeBox.kicad_sch]
2024-08-26 change mounting to via pads
    [JukeBox.kicad_pcb, JukeBox.kicad_sch]
2024-09-02 rearrange parts, fix nets
    [JukeBox.kicad_pcb, JukeBox.kicad_sch]
2024-09-02 add headphone jacks for i2c busses for expansion
    [JukeBox.kicad_pcb, JukeBox.kicad_sch]
2024-09-04 fix screen footprint, prepare for fab
    [JukeBox.kicad_pcb, JukeBox.kicad_sch]
2024-09-04 minor updates for production
    [JukeBox.kicad_pcb, JukeBox.kicad_sch]
2024-09-04 adjust case for new screen
    [case.scad]
2024-09-06 fix case bottom misalignment
    [case.scad]
2024-09-07 optimize case code
    [case.scad]
2024-09-07 update gitignore, more minor optimizations
    [case.scad]
2024-09-30 update flash chip, fix backlight transistor, adjust some holes for io, update readme for hardware
    [JukeBox.kicad_pcb, JukeBox.kicad_sch, USON-8_UX_2x3x0p6_WIN.step, case.scad]
2024-10-04 minor io adjustments
    [case.scad]
2024-10-05 remove headphone jack, switch to test pads, use 2020 leds and rearrange, move usb port
    [JukeBox.kicad_pcb, JukeBox.kicad_sch]
2024-10-10 add board id to lcd, other misc minor updates
    [JukeBox.kicad_sch, case.scad]
2024-10-28 switch to 2020 leds, switch to new key footprint, extend io connectors, update case geometry
    [JukeBox.kicad_pcb, JukeBox.kicad_sch, SM04B-SRSS-TB(LF)(SN).STEP, WS2812-2020.STEP, case.scad]
2024-10-28 remove old cad files, switch to 8MB flash
    [JukeBox.kicad_pcb, JukeBox.kicad_sch, USON-8_UX_2x3x0p6_WIN.step, W25Q64JVZPIQ-TR.step]
2024-10-28 add eeprom for configuring the device persistently
    [JukeBox.kicad_pcb, JukeBox.kicad_sch]
2024-11-04 minor eeprom updates
    [JukeBox.kicad_pcb]
2024-11-04 continue rework of gui
    [gui.rs]
2024-11-10 cut out greeting stage, transfer firmware version and device uid, update gui accordingly
2024-11-11 add peripherals and encoding, fix support for querying peripherals, switch from strings to vec u8s for serial processing, various other minor updates
    [led.rs, main.rs, mutex.rs, peripheral.rs, rgb.rs, screen.rs, serial.rs]
2024-11-11 rework pin initialization, clean up serial a bit, add mutex macro (DANGEROUS)
    [keyboard.rs, led.rs, main.rs, mutex.rs, peripheral.rs, rgb.rs, serial.rs]
2024-11-11 rename some things, switch to static mutexes, switch to "const default" for peripherals
2024-11-12 change responses to use \r\n\r\n, add serialerr for more error handling, add negativeack for host processing errors, add decoding for input events
    [gui.rs, peripheral.rs, reaction.rs, serial.rs]
2024-11-13 switch to anyhow, send keyboard presses to desktop
2024-11-14 add reaction handling thread, handle config via mutex
2024-11-15 add reaction thread, move config to mutex
2024-11-16 switch to internal kicad usb c, switch to pico clock, fix clock capacitance, fix rgb pinout, fix missing BOM materials
    [ECS-120-20-33-AEL-TR.step, JukeBox.kicad_pcb, JukeBox.kicad_sch, USB4105-GF-A.step]
2024-11-16 switch from 0805 to 0402
    [JukeBox.kicad_pcb, JukeBox.kicad_sch]
2024-11-16 update readmes, remove more redundant kicad elements
    [JukeBox.kicad_pcb, JukeBox.kicad_sch, W25Q64JVZPIQ-TR.step]
2024-11-16 switch to winresource for cross compiling
2024-11-19 add st7789 driver, still a bit slow
2024-11-19 switch to 16 bit autopull
2024-11-21 switch to generic bootloader
2024-11-21 update to rc design, update readme
    [JukeBox.kicad_pcb, JukeBox.kicad_sch]
2024-11-25 massive overhaul for comms (again), moved some common stuff to a util lib, reworked firmware to be compiled to multiple versions for different devices, start reworking gui to support multiple devices
    [gui.rs, keyboard.rs, main.rs, peripheral.rs, reaction.rs]
2024-12-12 add readme for firmware building, update case for final pcb
    [case.scad]
2024-12-13 make serial errors more descriptive, add more info for running on linux
    [serial.rs]
2024-12-14 switch certain caps back to 0805, update silkscreen
    [JukeBox.kicad_pcb, JukeBox.kicad_sch]
