NotQuiteApex/JukeBox/(notices)

Notices in the files:
hardware-pcb/JukeBox.kicad_pcb:
v5.6 - F.T.I. <3 (c) 2020-2025
